shreyD2408/Nugget_Desk_Buddy/BOM.csv

Item | Qty | Supplier | Cost/item | Total Cost | link
ESP32-S3-DevKitC-1 | 1 | AliExpress | $6.36 | $6.36 | https://www.aliexpress.com/item/1005006737960797.html?curPageLogUid=3MMSdtJtNgLH
1.8" TFT Display | 1 | AliExpress | $3.47 | $3.47 | https://www.aliexpress.com/item/1005006139989470.html?curPageLogUid=MMpzxSajoxAi
Capacitive Touch Sensors - 20 Pack | 1 | AliExpress | $2.96 | $2.96 | https://www.aliexpress.com/item/1005006246380749.html?curPageLogUid=93rOwuYtwXIy
MAX98357A Audio Amplifier | 1 | AliExpress | $1.55 | $1.55 | https://www.aliexpress.com/item/1005007003802663.html?curPageLogUid=GHZ1DjOIE08D
L298N Mini | 1 | AliExpress | $1.57 | $1.57 | https://www.aliexpress.com/item/1005012607171084.html?curPageLogUid=zB9nHcws6F3z
MPU6050 | 1 | AliExpress | $2.43 | $2.43 | https://www.aliexpress.com/item/1005010057794277.html?curPageLogUid=pIY97fFPeKLu
Estimated total shipping | 1 |  |  | $0.00
