shreyD2408/Nugget_Desk_Buddy/cad/step/Servo_Holder.step

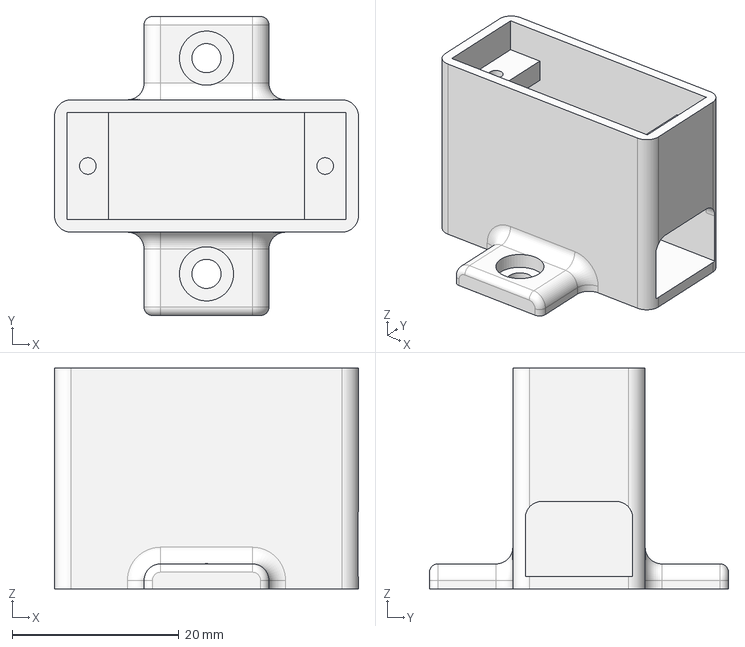
[picture p1: CAD file, 2026-11-01]
cad/step/Servo_Holder.step
36.5 x 35.9 x 26.5 mm
