shreyD2408/Nugget_Desk_Buddy/cad/step/Tyre_Rim.step

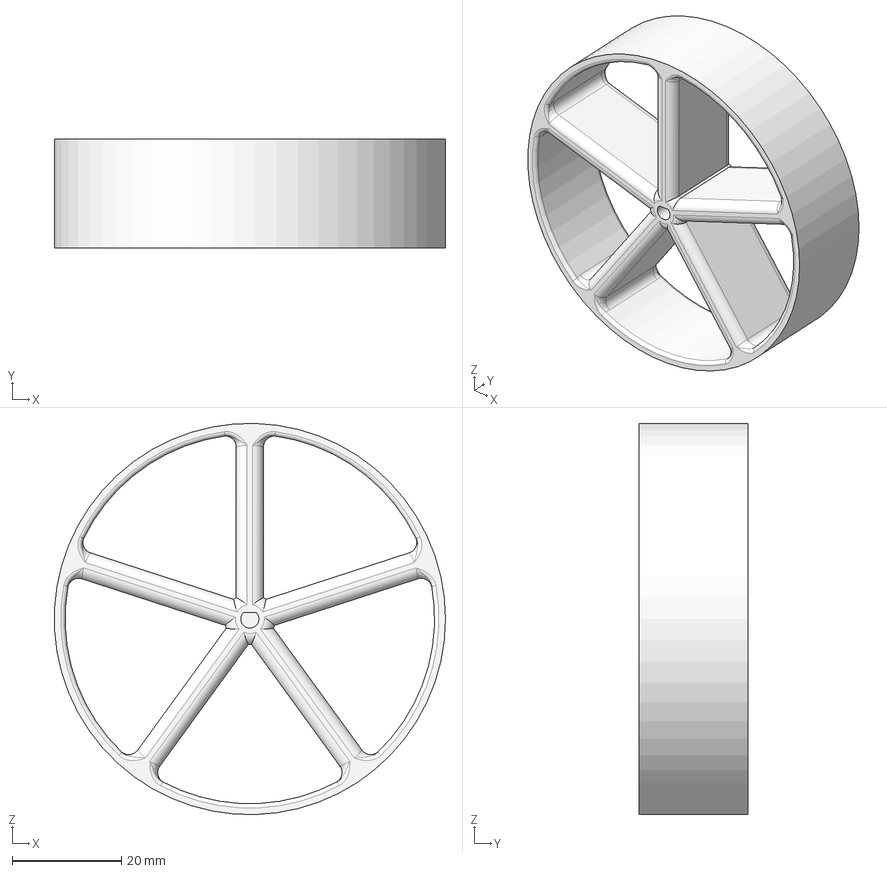
[picture p2: CAD file, 2026-11-01]
cad/step/Tyre_Rim.step
71.4 x 20.0 x 71.5 mm
