shreyD2408/Nugget_Desk_Buddy/cad/step/Rib_Rod.step

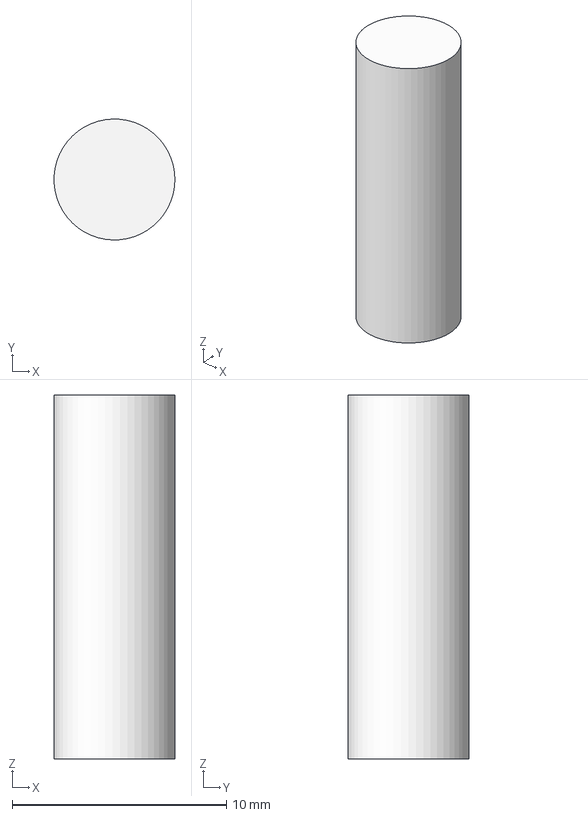
[picture p3: CAD file, 2026-11-01]
cad/step/Rib_Rod.step
5.64 x 5.65 x 17.0 mm
