shreyD2408/Nugget_Desk_Buddy/cad/step/Top_Cover.step

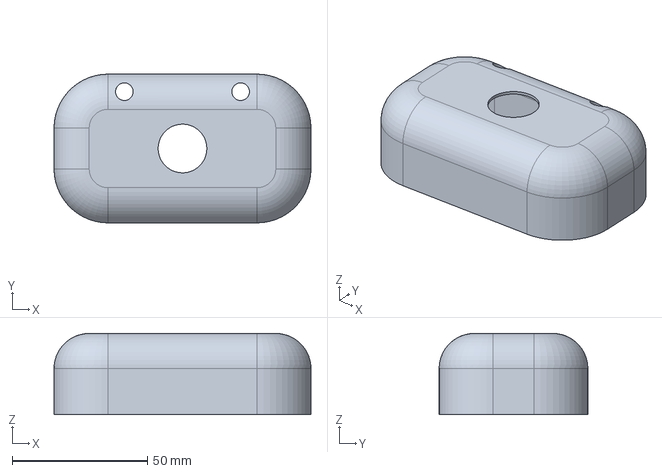
[picture p4: CAD file, 2026-11-01]
cad/step/Top_Cover.step
95.0 x 55.0 x 30.0 mm
