shreyD2408/Nugget_Desk_Buddy/cad/step/Rib.step

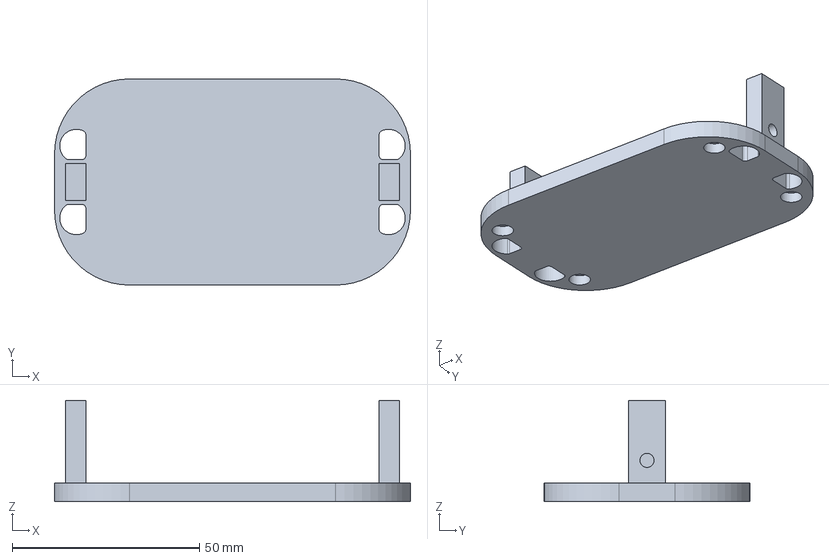
[picture p5: CAD file, 2026-11-01]
cad/step/Rib.step
95.0 x 55.0 x 27.0 mm
