shreyD2408/Nugget_Desk_Buddy/cad/step/Battery_Cover.step

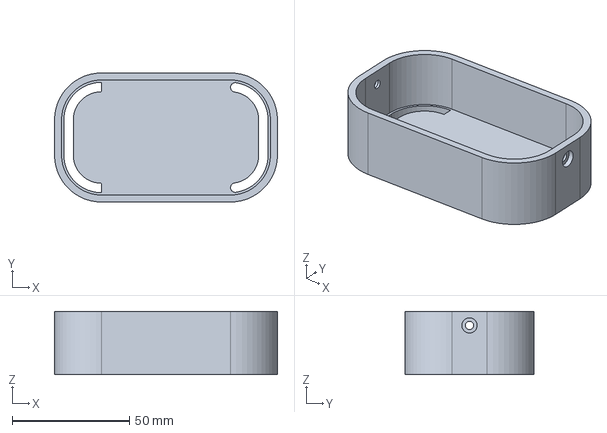
[picture p6: CAD file, 2026-11-01]
cad/step/Battery_Cover.step
95.0 x 55.0 x 27.0 mm
