shreyD2408/Nugget_Desk_Buddy/cad/step/Tyre.step

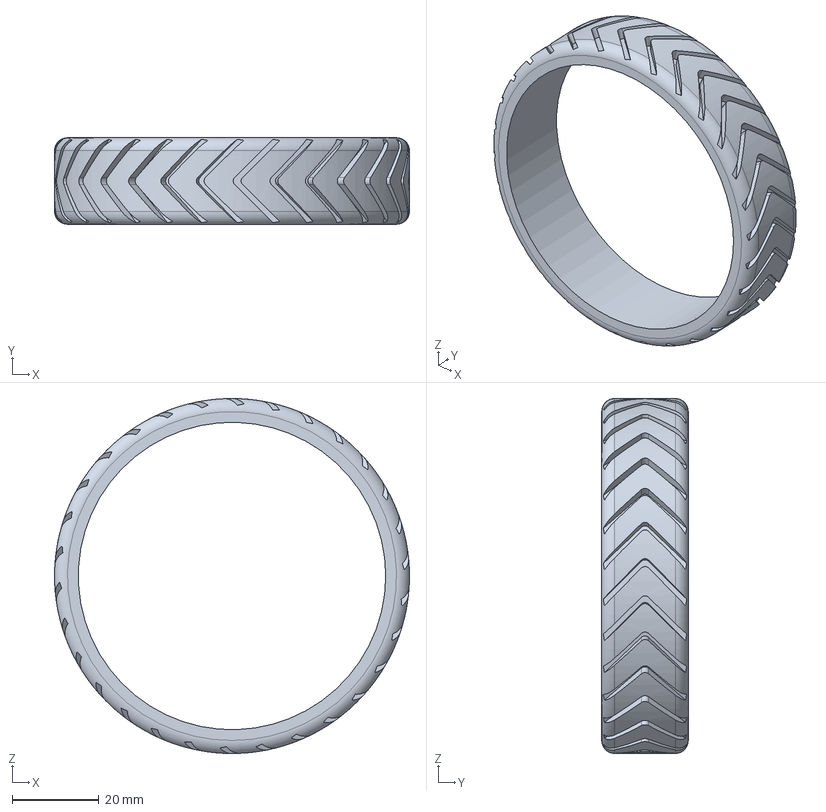
[picture p7: CAD file, 2026-11-01]
cad/step/Tyre.step
82.0 x 20.0 x 82.0 mm
