shreyD2408/Nugget_Desk_Buddy/cad/step/Base_Top.step

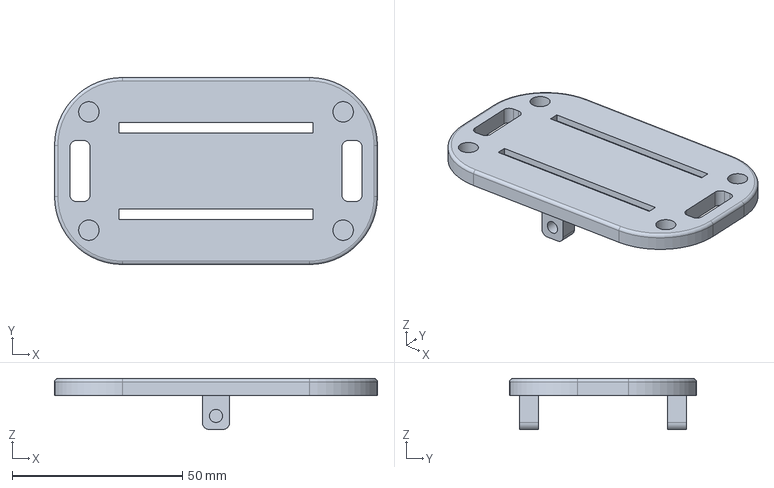
[picture p8: CAD file, 2026-11-01]
cad/step/Base_Top.step
95.0 x 55.0 x 15.0 mm
