shreyD2408/Nugget_Desk_Buddy/cad/step/Touch Sensor Bracket.step

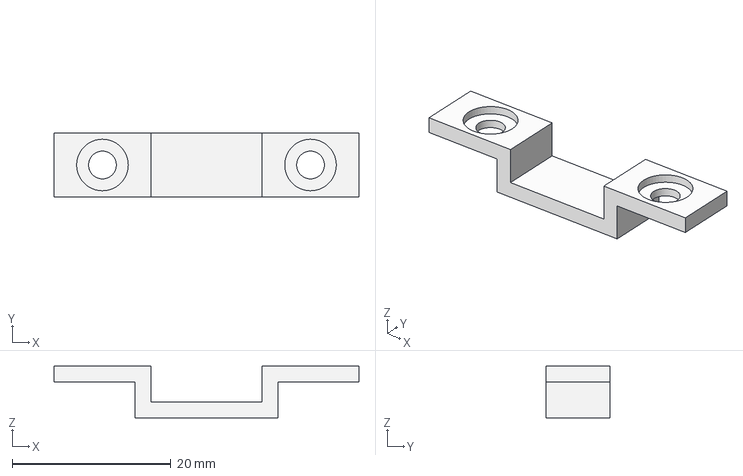
[picture p9: CAD file, 2026-11-01]
cad/step/Touch Sensor Bracket.step
38.4 x 8.00 x 6.50 mm
