shreyD2408/Nugget_Desk_Buddy/cad/step/Head_Back.step

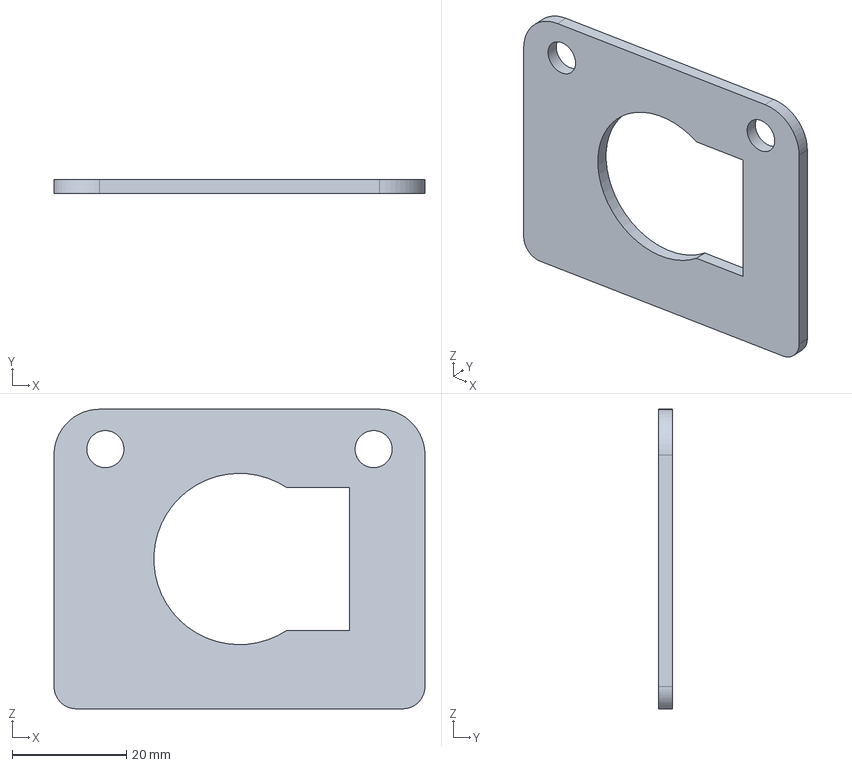
[picture p10: CAD file, 2026-11-01]
cad/step/Head_Back.step
65.0 x 2.50 x 52.5 mm
