shreyD2408/Nugget_Desk_Buddy/cad/step/Head.step

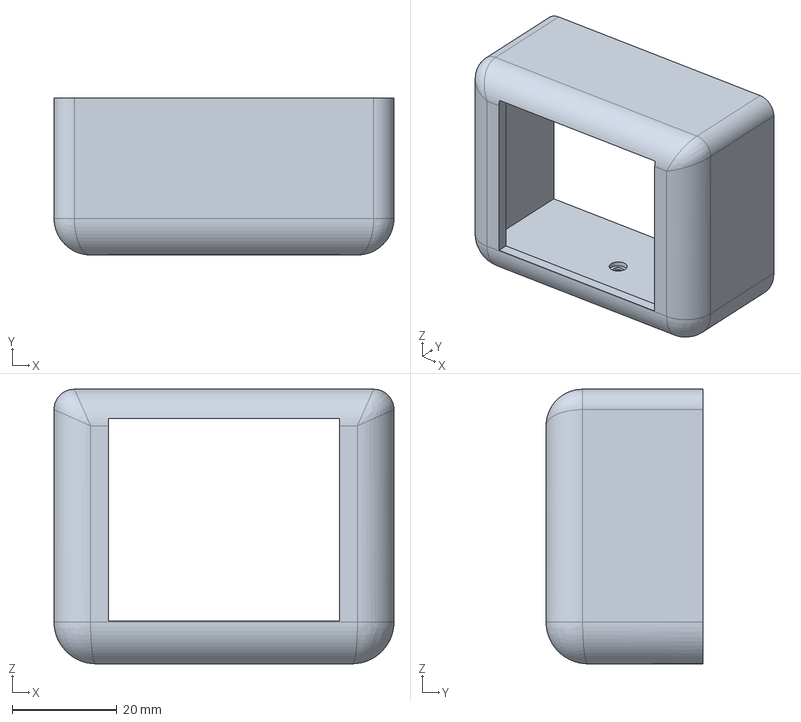
[picture p11: CAD file, 2026-11-01]
cad/step/Head.step
65.0 x 30.0 x 52.5 mm
