shreyD2408/Nugget_Desk_Buddy/cad/step/Base.step

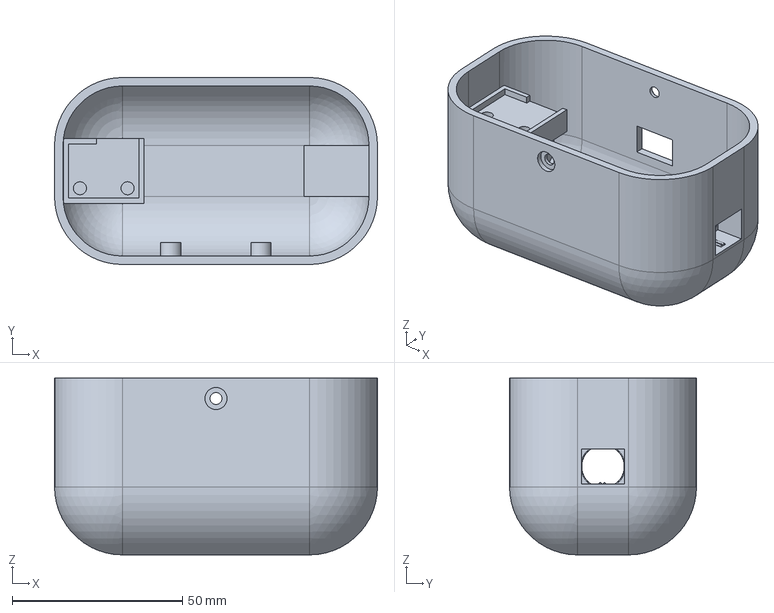
[picture p12: CAD file, 2026-11-01]
cad/step/Base.step
95.0 x 55.0 x 52.0 mm
