shreyD2408/Nugget_Desk_Buddy/(list of files, cad)

Other CAD files:
cad/stl/Base.stl
cad/stl/Base_Top.stl
cad/stl/Battery_Cover.stl
cad/stl/Head.stl
cad/stl/Head_Back.stl
cad/stl/Rib.stl
cad/stl/Rib_Rod.stl
cad/stl/Servo_Holder.stl
cad/stl/Top_Cover.stl
cad/stl/Touch Sensor Bracket.stl
cad/stl/Tyre.stl
cad/stl/Tyre_Rim.stl
