shreyD2408/Nugget_Desk_Buddy/schematic/Nugget_Desk_Buddy.kicad_sch

## KiCad design schematic/Nugget_Desk_Buddy.kicad_sch (2026-11-01)

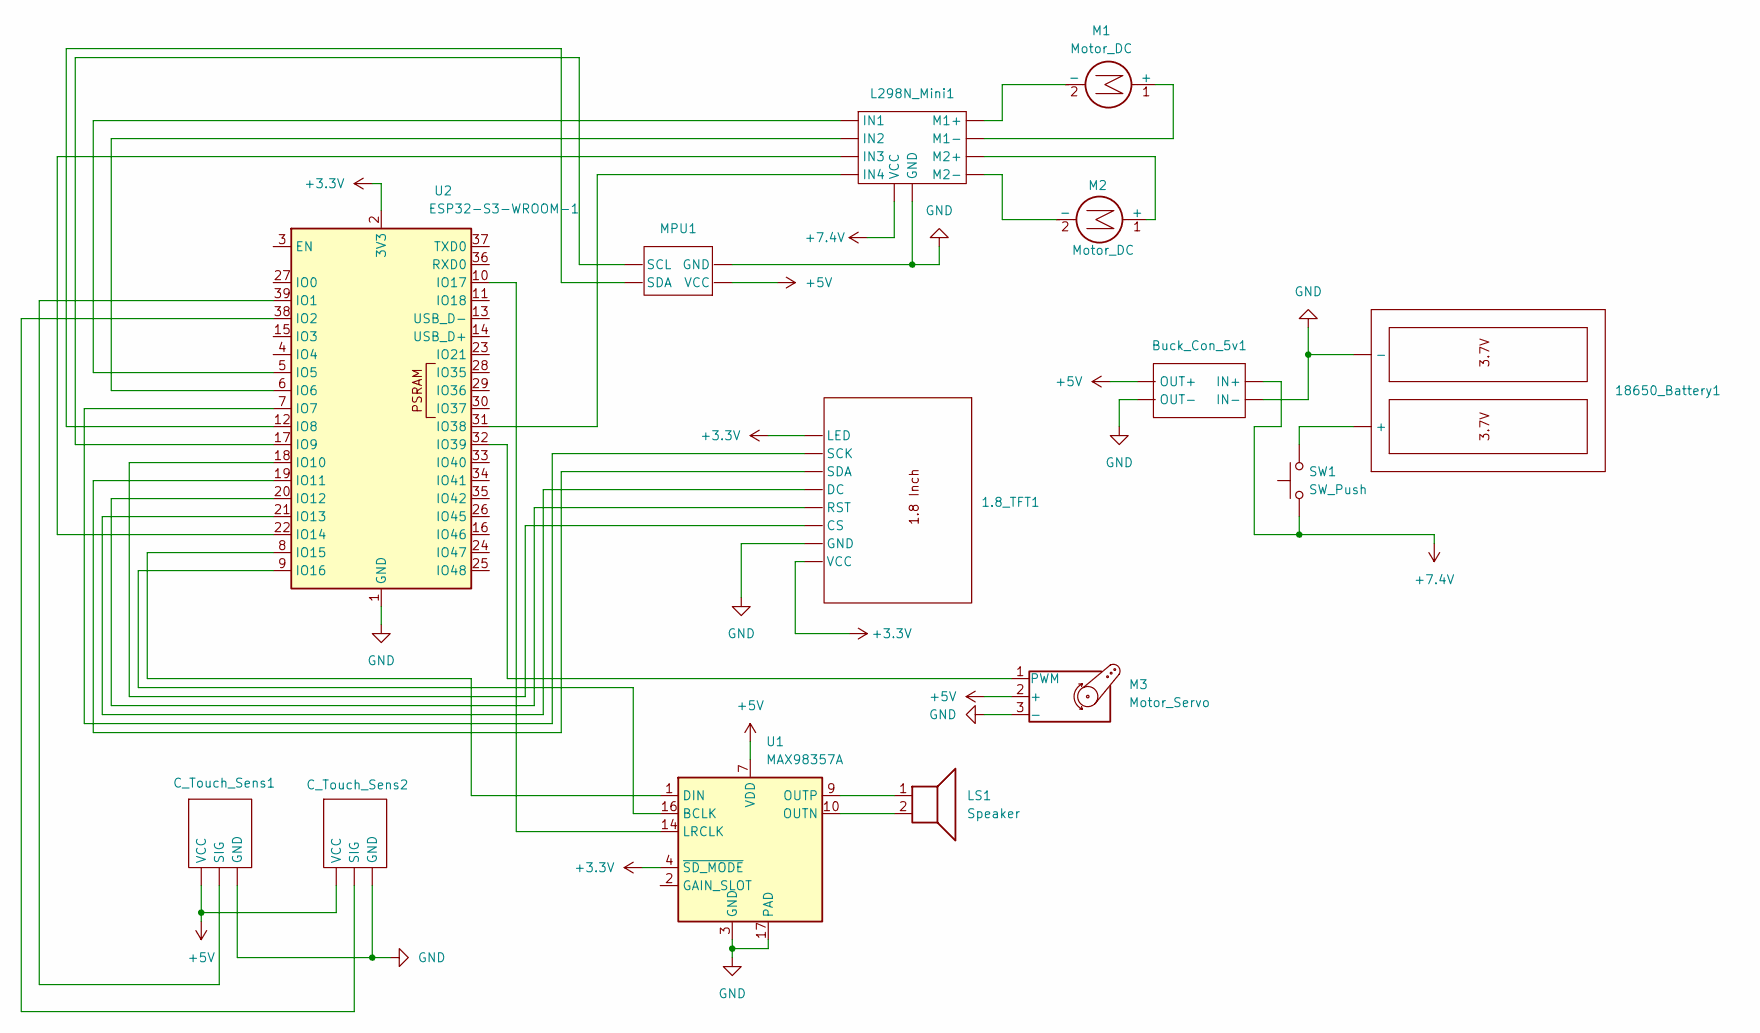
[picture p13: schematic Nugget_Desk_Buddy.kicad_sch]

Parts:
1.8_TFT1: Microchip_TFBGA-196_11x11mm_Layout14x14_P0.75mm_SMD
18650_Battery1: Converter_ACDC_Hahn_HS-400xx_THT
Buck_Con_5v1: Microchip_TFBGA-196_11x11mm_Layout14x14_P0.75mm_SMD
C_Touch_Sens1, C_Touch_Sens2: Microchip_TFBGA-196_11x11mm_Layout14x14_P0.75mm_SMD
L298N_Mini1: (no value)
LS1: Speaker; SOIC-28W_7.5x17.9mm_P1.27mm
M1, M2: Motor_DC
M3: Motor_Servo; WSON-8-1EP_6x5mm_P1.27mm_EP3.4x4mm
MPU1: Microchip_TFBGA-196_11x11mm_Layout14x14_P0.75mm_SMD
SW1: SW_Push; DIP-24_W7.62mm
U1: MAX98357A; TQFN-16-1EP_3x3mm_P0.5mm_EP1.23x1.23mm
U2: ESP32-S3-WROOM-1

Connections:
+3.3V: 1.8_TFT1., U1.4 (~SD_MODE), U2.2 (3V3)
+5V: Buck_Con_5v1., C_Touch_Sens1., C_Touch_Sens2., M3.2 (+), MPU1., U1.7 (VDD), U1.8 (VDD)
+7.4V: Buck_Con_5v1., L298N_Mini1., SW1.1
GND: 1.8_TFT1., 18650_Battery1., Buck_Con_5v1., C_Touch_Sens1., C_Touch_Sens2., L298N_Mini1., M3.3 (-), MPU1., U1.3 (GND), U1.11 (GND), U1.15 (GND), U1.17 (PAD), U2.1 (GND), U2.40 (GND), U2.41 (GND)
unnamed: 1.8_TFT1., U2.7 (IO7), U2.18 (IO10), U2.19 (IO11), U2.20 (IO12), U2.21 (IO13)
unnamed: 18650_Battery1., SW1.2
unnamed: C_Touch_Sens1., U2.39 (IO1)
unnamed: C_Touch_Sens2., U2.38 (IO2)
unnamed: L298N_Mini1., M1.1 (+), M1.2 (-), M2.1 (+), M2.2 (-), U2.5 (IO5), U2.6 (IO6), U2.22 (IO14), U2.31 (IO38)
unnamed: LS1.1, U1.9 (OUTP)
unnamed: LS1.2, U1.10 (OUTN)
unnamed: M3.1 (PWM), U2.32 (IO39)
unnamed: MPU1., U2.12 (IO8), U2.17 (IO9)
unnamed: U1.1 (DIN), U2.8 (IO15)
unnamed: U1.14 (LRCLK), U2.10 (IO17)
unnamed: U1.16 (BCLK), U2.9 (IO16)
