shreyD2408/Nugget_Desk_Buddy/JOURNAL.md

# Nugget Desk Buddy: devlog

<!-- Generated by Half Life from project f4esei13xrel8ebnuniq8spb. Edits here are overwritten on the next sync. -->
<!-- Generated: 2026-11-01T21:52:56.110Z -->

> [!NOTE]
> This devlog is mirrored from [Half Life](https://halflife.hackclub.com) ([open the project](https://halflife.hackclub.com/projects/f4esei13xrel8ebnuniq8spb)). Editing it here will not change the platform's copy, and the next sync overwrites this file.

> An interactive, two-wheeled self-balancing companion robot built around an ESP32-S3 DevKitC-1 microcontroller. This project combines high-speed embedded control loops, physical computing, and IoT web interfaces by integrating real-time MPU6050 PID balancing, digital I2S audio feedback, capacitive touch sensors, a mechanical neck servo, and a custom 1.8-inch TFT display with an onboard HTTP web dashboard for seamless wireless teleoperation.

| Week | Tier | Hours logged | Entries |
| --- | --- | --- | --- |
| Week 4 | Tier 1 | 22.92h | 8 |

## Contents

1. [2026-10-27: Work session](#2026-10-27-work-session)
2. [2026-10-27: Work session](#2026-10-27-work-session)
3. [2026-10-28: Work session](#2026-10-28-work-session)
4. [2026-10-29: Work session](#2026-10-29-work-session)
5. [2026-10-30: Work session](#2026-10-30-work-session)
6. [2026-11-01: Work session](#2026-11-01-work-session)
7. [2026-11-01: Work session](#2026-11-01-work-session)
8. [2026-11-01: Work session](#2026-11-01-work-session)

## Design

### 2026-10-27: Work session

**4.18h**

[Timelapse](https://lookout.hackclub.com/api/media/cd934b0d-7e5d-4032-8170-0f6390b89ad4/video.mp4)

### 2026-10-27: Work session

**3.8h**

[Timelapse](https://lookout.hackclub.com/api/media/fa851f80-64cd-4be9-90be-d6bd983788ea/video.mp4)

### 2026-10-28: Work session

**2.97h**

[Timelapse](https://lookout.hackclub.com/api/media/4d9594f0-5c12-4dbd-bf87-edb254e5596a/video.mp4)

### 2026-10-29: Work session

**0.42h**

[Timelapse](https://lookout.hackclub.com/api/media/dbc1eecf-297b-4caa-9b0d-4f567d426acd/video.mp4)

### 2026-10-30: Work session

**2.55h**

[Timelapse](https://lookout.hackclub.com/api/media/35569597-e5ab-451f-897c-50cbd66faa41/video.mp4)

### 2026-11-01: Work session

**7.42h**

[Timelapse](https://lookout.hackclub.com/api/media/e8d138c3-4ff4-47b4-8606-2a487177cb4b/video.mp4)

### 2026-11-01: Work session

**0.23h**

[Timelapse](https://lookout.hackclub.com/api/media/302fd4e2-434b-4581-b043-7759656dc3d7/video.mp4)

### 2026-11-01: Work session

**1.35h**

[Timelapse](https://lookout.hackclub.com/api/media/a780bdb4-ce73-48ab-a516-45366fd3ff34/video.mp4)
