shreyD2408/Nugget_Desk_Buddy/(commit log)

2026-10-26 Sync Nugget Desk Buddy from Half Life
    [BOM.csv]
2026-11-01 Enhance README with detailed features and setup
    Expanded details on the onboard web dashboard, added hardware overview, wiring diagram, and software setup instructions.
